muehlenb/Mocap-Pi/app/data/font/texture.png

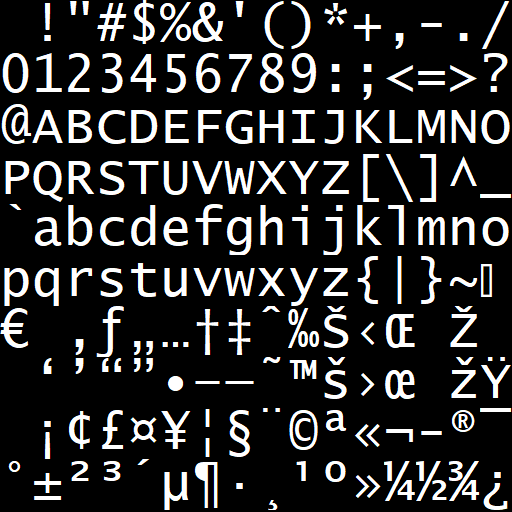
app/data/font/texture.png
