muehlenb/Mocap-Pi/img/main-camera-views.jpg

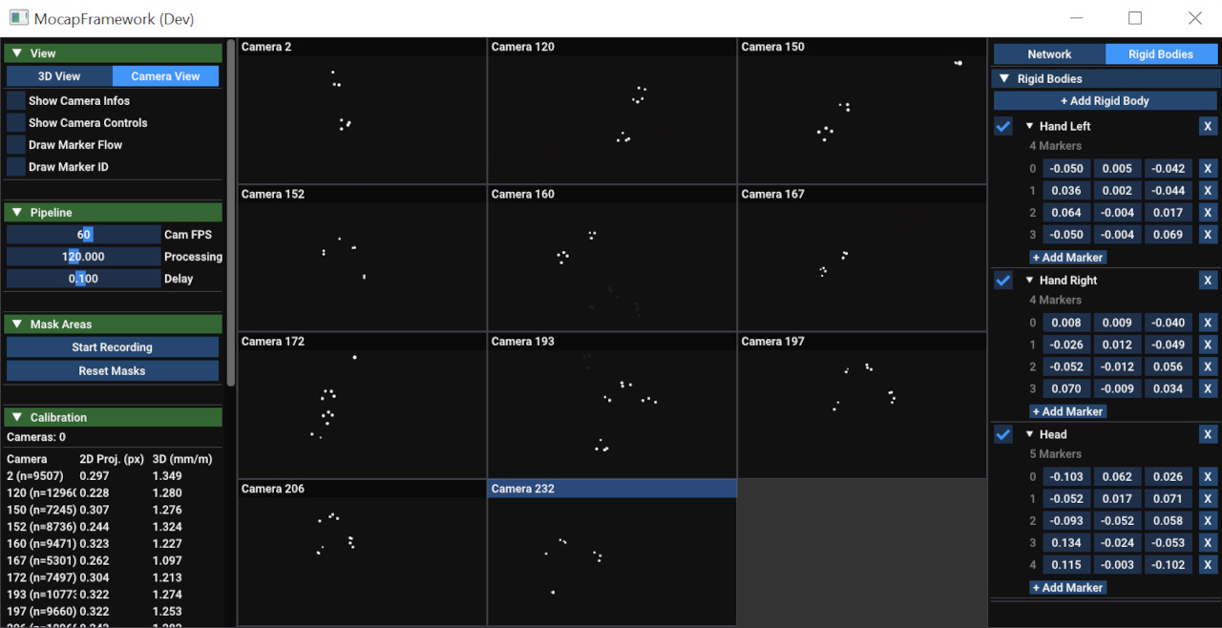
img/main-camera-views.jpg
