muehlenb/Mocap-Pi/img/software-architecture.png

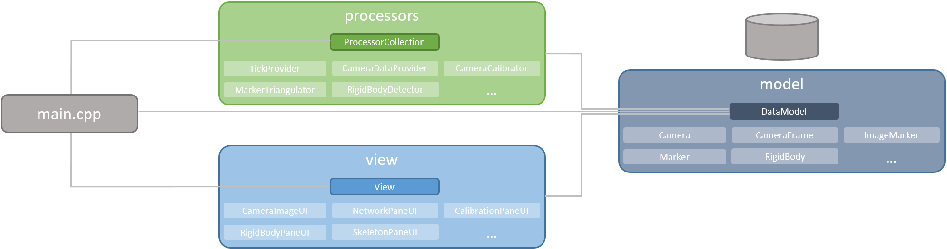
img/software-architecture.png
