muehlenb/Mocap-Pi/app/data/model/camera.obj

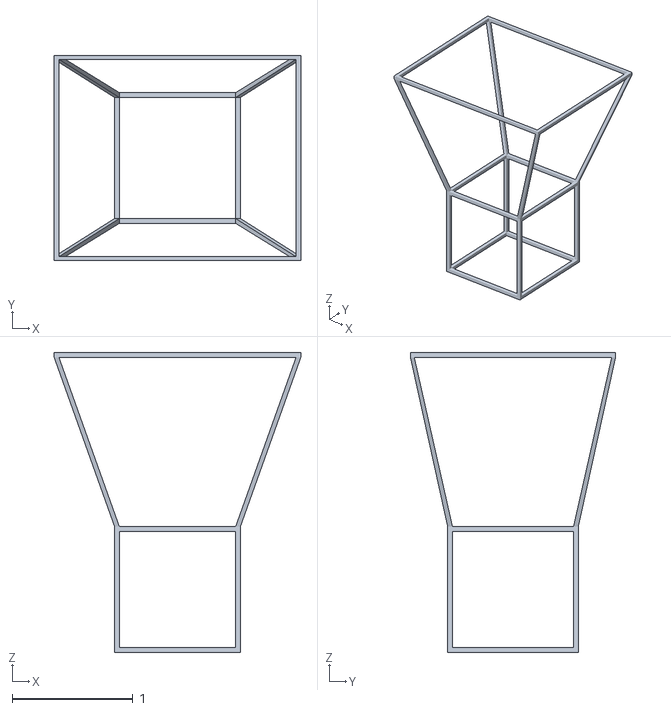
[picture p6: CAD file, 2026-10-22]
app/data/model/camera.obj
2.04 x 1.70 x 2.48
