muehlenb/Mocap-Pi/utils/stl-files/top.stl

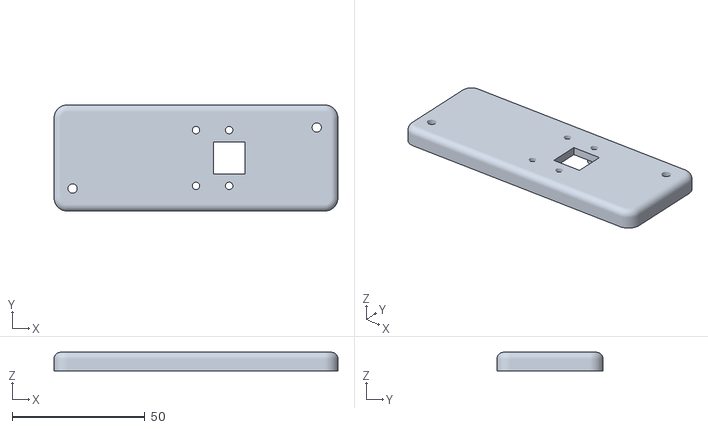
[picture p7: CAD file, 2026-10-22]
utils/stl-files/top.stl
107.0 x 40.0 x 7.00
