muehlenb/Mocap-Pi/app/data/model/ray.obj

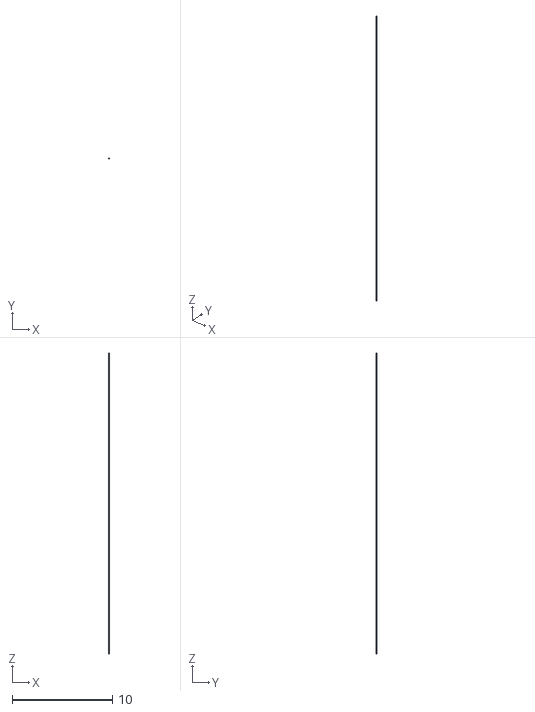
[picture p8: CAD file, 2026-10-22]
app/data/model/ray.obj
0.04 x 0.04 x 30.0
