muehlenb/Mocap-Pi/utils/stl-files/bottom.stl

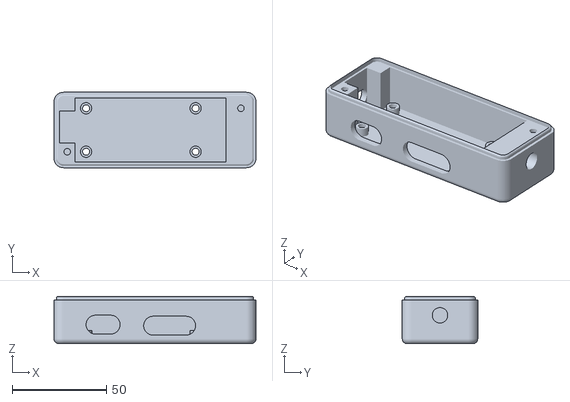
[picture p9: CAD file, 2026-10-22]
utils/stl-files/bottom.stl
107.0 x 40.0 x 25.0
