muehlenb/Mocap-Pi/app/data/model/sphere_low.obj

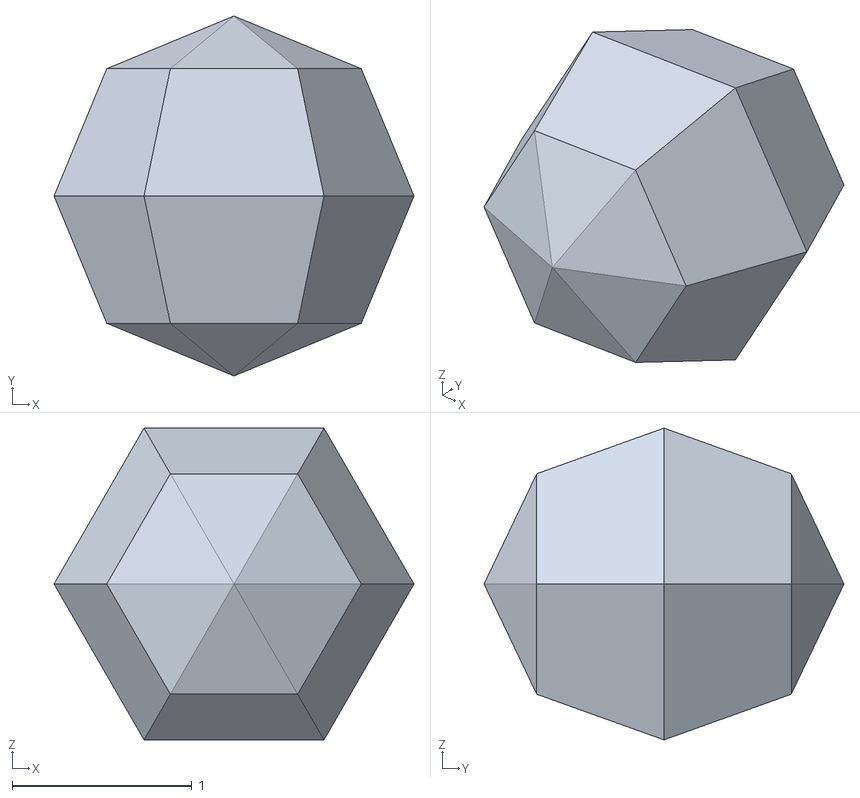
[picture p10: CAD file, 2026-10-22]
app/data/model/sphere_low.obj
2.00 x 2.00 x 1.73
