muehlenb/Mocap-Pi/img/main-calibration-menu.png

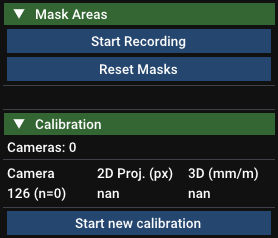
img/main-calibration-menu.png
