muehlenb/Mocap-Pi/(commit log)

2026-10-19 Added Infos about the stl files.
2026-10-19 Updated the stl file image.
2026-10-19 Updated Camera Readme
2026-10-20 Added the camera software.
2026-10-20 Added camera software image
2026-10-20 Updated Readme.md with the infos for the camera image.
2026-10-21 Worked on usage explanation of camera settings.
2026-10-21 Calibration explanation added.
2026-10-21 Updated Calibration Info.
2026-10-22 Updated / fixed camera views image.
2026-11-06 Fixed CameraView freeze bug.
